michelevalotti/thock42/trackpad_bracket.step

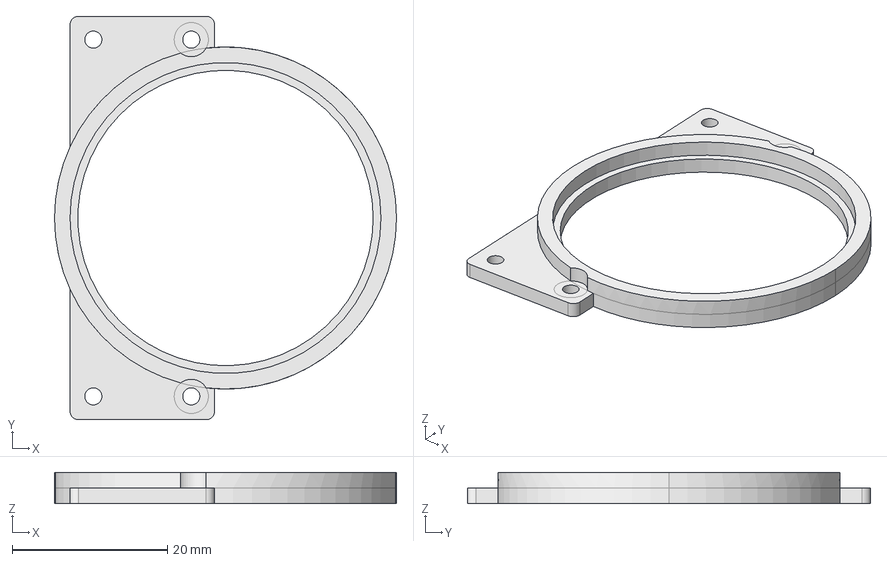
[picture p1: CAD file, 2024-04-23]
trackpad_bracket.step
44.0 x 51.9 x 4.00 mm
