michelevalotti/thock42/thock42.kicad_pcb

## KiCad design thock42.kicad_pcb (2024-06-29)

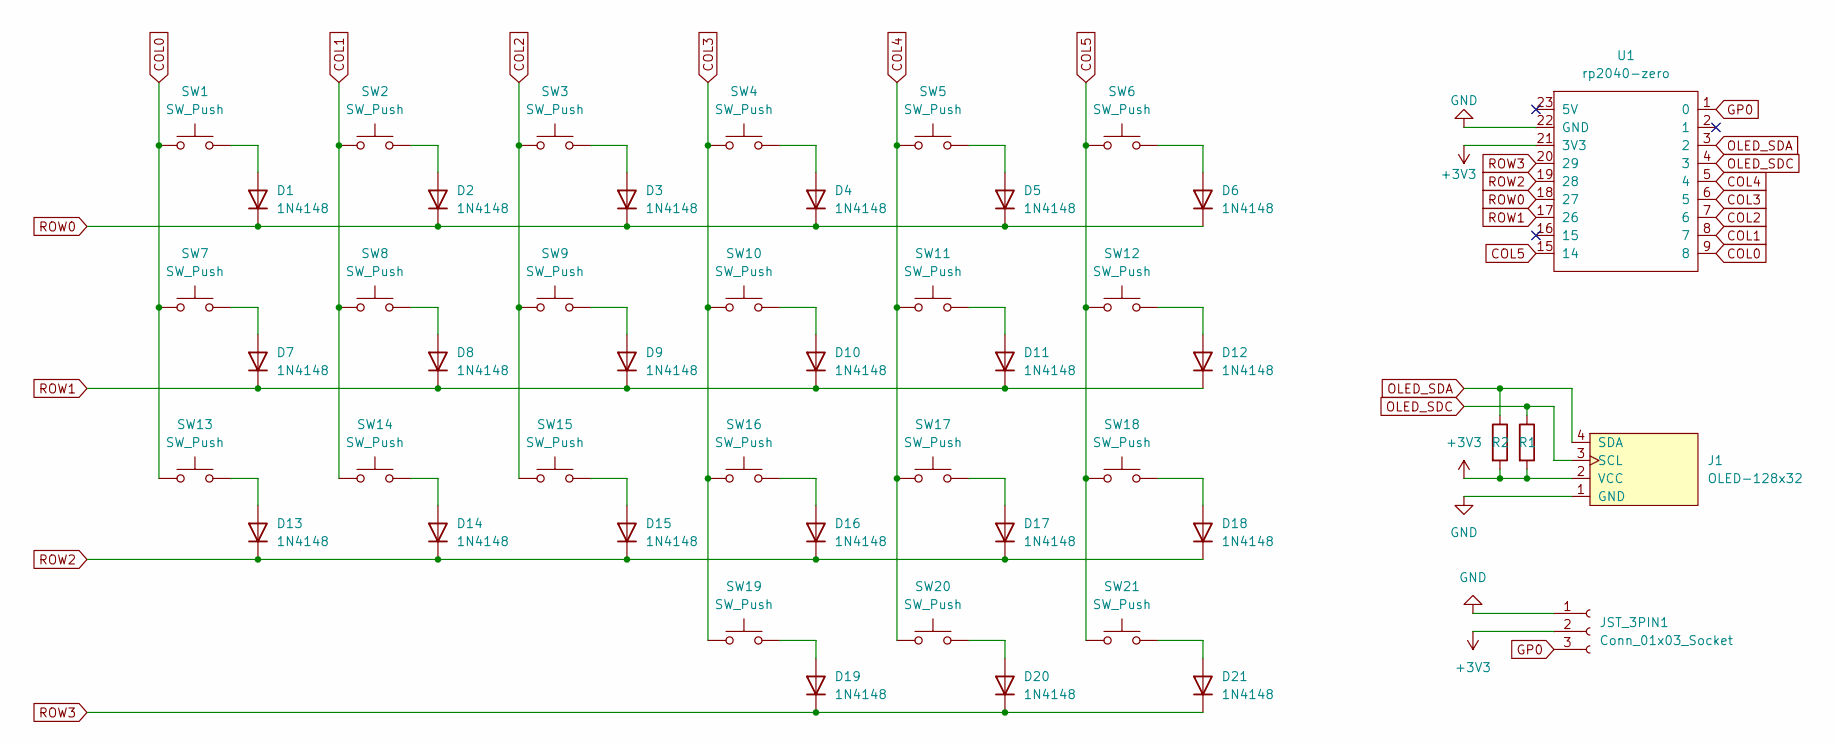
[picture p2: schematic thock42.kicad_sch]

Parts:
D1, D2, D3, D4, D5, D6, D7, D8, D9, D10, D11, D12, D13, D14, D15, D16, D17, D18, D19, D20, D21: 1N4148; D_DO-35_SOD27_P7.62mm_Horizontal
J1: OLED-128x32; OLED-128x32-double-sided
JST_3PIN1: Conn_01x03_Socket; JST_PH_S3B-PH-K_1x03_P2.00mm_Horizontal
R1, R2: R; R_Axial_DIN0207_L6.3mm_D2.5mm_P10.16mm_Horizontal
SW1, SW2, SW3, SW4, SW5, SW6, SW7, SW8, SW9, SW10, SW11, SW12, SW13, SW14, SW15, SW16, SW17, SW18, SW19, SW20, SW21: SW_Push; pg1350-RH_silkscreen
U1: rp2040-zero; rp2040-zero-tht_nobtm_reversible

Connections:
+3V3: J1.2 (VCC), JST_3PIN1.2, R1.2, R2.2, U1.21 (3V3); also elsewhere on the board
COL0: SW1.1, SW7.1, SW13.1, U1.9 (8)
COL1: SW2.1, SW8.1, SW14.1, U1.8 (7)
COL2: SW3.1, SW9.1, SW15.1, U1.7 (6)
COL3: SW4.1, SW10.1, SW16.1, SW19.1, U1.6 (5)
COL4: SW5.1, SW11.1, SW17.1, SW20.1, U1.5 (4)
COL5: SW6.1, SW12.1, SW18.1, SW21.1, U1.15 (14)
GND: J1.1 (GND), JST_3PIN1.1, U1.22 (GND); also elsewhere on the board
GP0: JST_3PIN1.3, U1.1 (0); also elsewhere on the board
unnamed: D1.2 (A), SW1.2
unnamed: D2.2 (A), SW2.2
unnamed: D3.2 (A), SW3.2
unnamed: D4.2 (A), SW4.2
unnamed: D5.2 (A), SW5.2
unnamed: D6.2 (A), SW6.2
unnamed: D7.2 (A), SW7.2
unnamed: D8.2 (A), SW8.2
unnamed: D9.2 (A), SW9.2
unnamed: D10.2 (A), SW10.2
unnamed: D11.2 (A), SW11.2
unnamed: D12.2 (A), SW12.2
unnamed: D13.2 (A), SW13.2
unnamed: D14.2 (A), SW14.2
unnamed: D15.2 (A), SW15.2
unnamed: D16.2 (A), SW16.2
unnamed: D17.2 (A), SW17.2
unnamed: D18.2 (A), SW18.2
unnamed: D19.2 (A), SW19.2
unnamed: D20.2 (A), SW20.2
unnamed: D21.2 (A), SW21.2
OLED_SDA: J1.4 (SDA), R2.1, U1.3 (2)
OLED_SDC: J1.3 (SCL), R1.1, U1.4 (3)
ROW0: D1.1 (K), D2.1 (K), D3.1 (K), D4.1 (K), D5.1 (K), D6.1 (K), U1.18 (27)
ROW1: D7.1 (K), D8.1 (K), D9.1 (K), D10.1 (K), D11.1 (K), D12.1 (K), U1.17 (26)
ROW2: D13.1 (K), D14.1 (K), D15.1 (K), D16.1 (K), D17.1 (K), D18.1 (K), U1.19 (28)
ROW3: D19.1 (K), D20.1 (K), D21.1 (K), U1.20 (29)

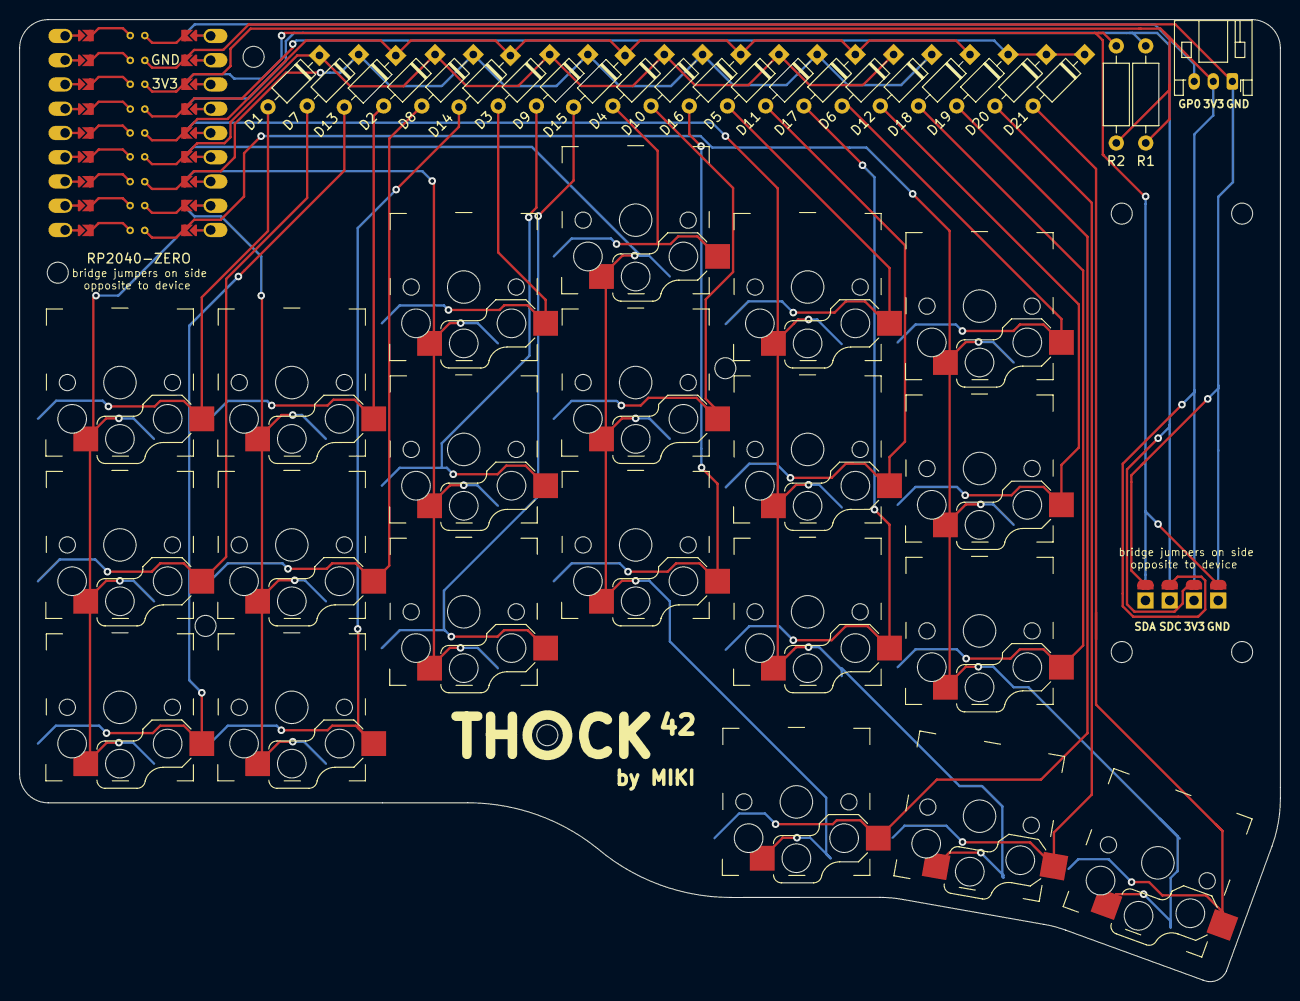
[picture p3: board thock42.kicad_pcb from above]

Board: 2 copper layers, 132.0 x 100.7 mm, 47 parts (0 on the bottom side), 36 nets.

Other parts of the board:
JST_3PIN: Conn_01x03_Socket; JST_PH_S3B-PH-K_1x03_P2.00mm_Horizontal

Their connections:
+3V3: JST_3PIN.2; also elsewhere on the board
GND: JST_3PIN.1; also elsewhere on the board
GP0: JST_3PIN.3; also elsewhere on the board
