michelevalotti/thock42/(commit log)

2024-04-04 first commit: schematics and pcb
    [thock42.kicad_pcb, thock42.kicad_sch]
2024-04-05 4pin jst with i2c changed to 3pin jst with serial
    [thock42.kicad_pcb, thock42.kicad_sch]
2024-04-08 feat: add switch id silkscreen
    [thock42.kicad_pcb, thock42.kicad_sch]
2024-04-11 feat: add more mounting holes
    [thock42.kicad_pcb]
2024-04-14 add symbols and footprints libraries
2024-04-14 update links to libs, jst footprint, and add add mounting hole
    [thock42.kicad_pcb, thock42.kicad_sch]
2024-05-23 add i2c pullups and redesign thumb cluster
    [thock42.kicad_pcb, thock42.kicad_sch]
2024-05-23 add space between resistors and change some silkscreen labels
    [thock42.kicad_pcb]
2024-05-26 moev thumb cluster down by .2mm
    [thock42.kicad_pcb]
2024-05-26 fix clearance errors
    [thock42.kicad_pcb]
2024-05-26 move mounting point
    [thock42.kicad_pcb]
2024-06-29 move index col down to align with ring col
    [thock42.kicad_pcb]
